Sles73/rocketa/OpenRocket/Valentina/decals/image-removebg-preview (3).png

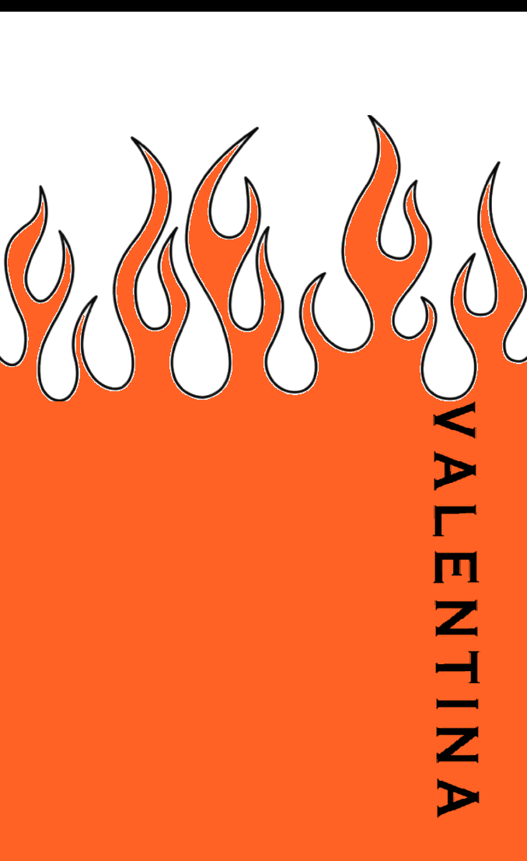
OpenRocket/Valentina/decals/image-removebg-preview (3).png
