Sles73/rocketa/construction/parts_V2.FCStd

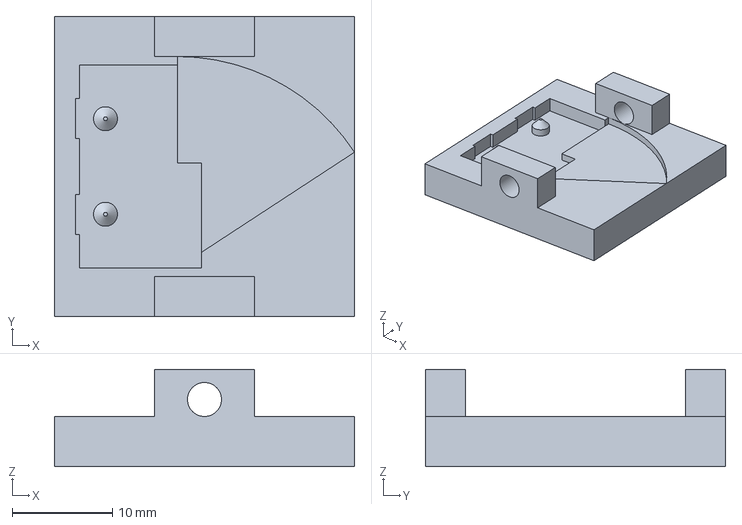
[picture p9: CAD file, 2026-05-04]
construction/parts_V2.FCStd
30.0 x 30.0 x 9.70 mm
