Sles73/rocketa/pcb/avionics/outline/pcb_outline_Page__.dxf

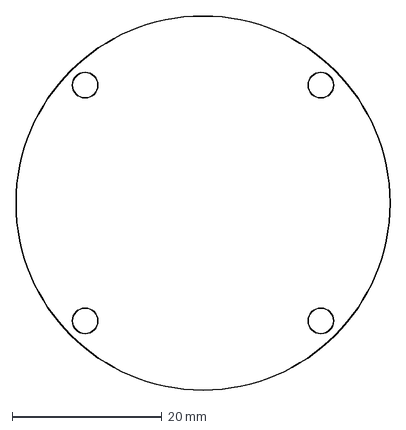
[picture p10: CAD file, 2026-05-04]
pcb/avionics/outline/pcb_outline_Page__.dxf
50.0 x 50.0 mm
