Sles73/rocketa/construction/parts.FCStd

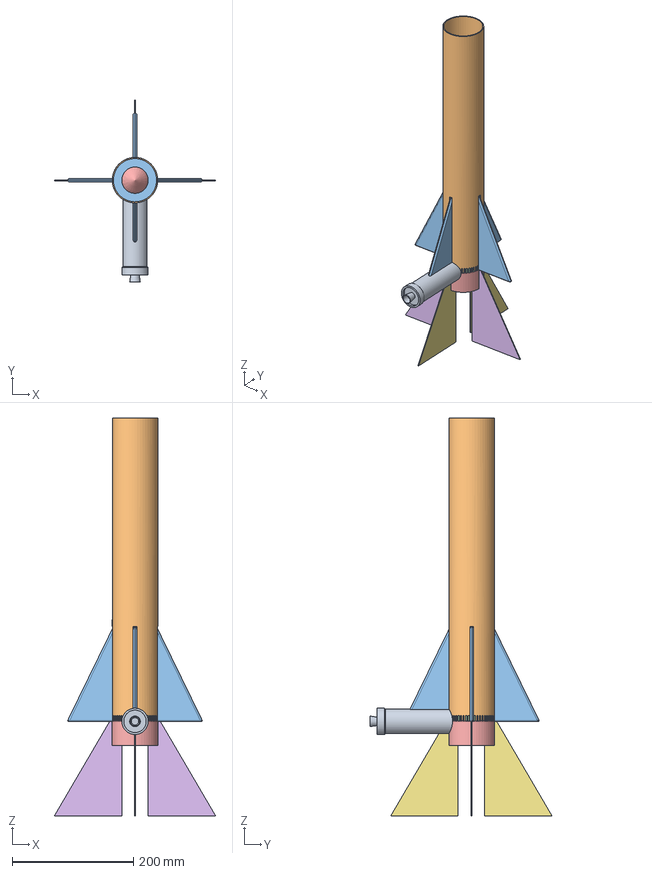
[picture p11: CAD file, 2026-05-04]
construction/parts.FCStd
266.1 x 300.3 x 656.0 mm
motorest
trubka
finsBody
cupler
mm1
mm2
