Sles73/rocketa/(list of files, cad)

Other CAD files:
pcb/avionics-com/outline/pcb_outline.FCStd
pcb/avionics-core-noob/outline/pcb_outline.FCStd
pcb/avionics-core/outline/pcb_outline.FCStd
pcb/avionics-power/outline/pcb_outline.FCStd
construction/rockter_realne.FCStd
pcb/avionics/outline/pcb_outline.FCStd
construction/rockter_mock.FCStd
