Sles73/rocketa/pcb/avionics-power/avionics.kicad_pcb

## KiCad design pcb/avionics-power/avionics.kicad_pcb (2026-05-04)

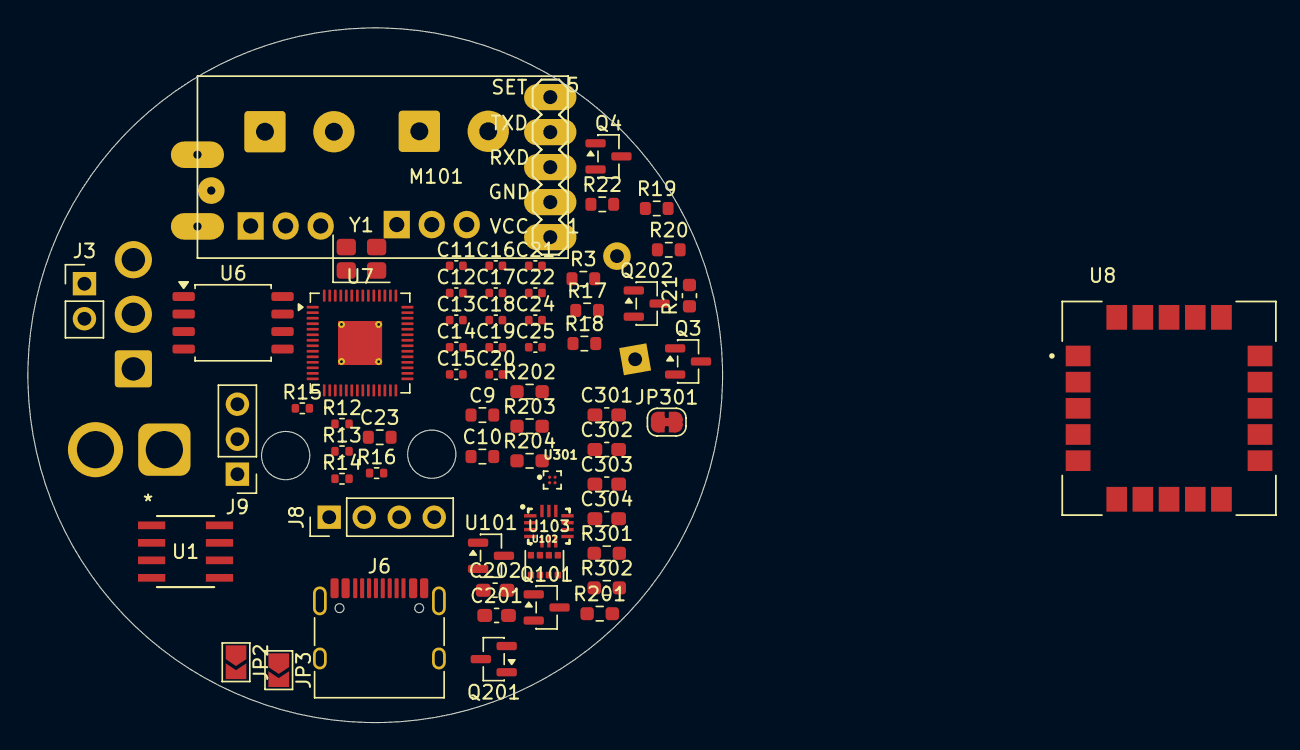
[picture p12: board avionics.kicad_pcb from above]

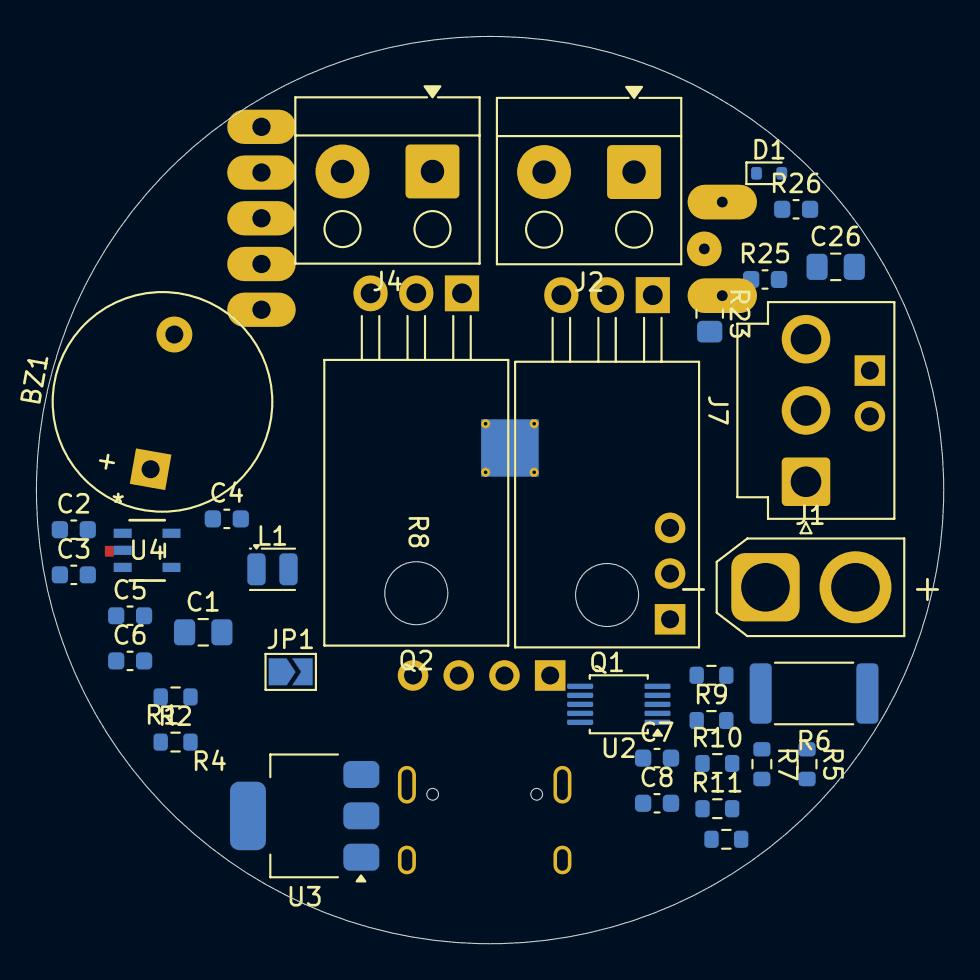
[picture p13: board avionics.kicad_pcb from below]

Board: 2 copper layers, 50.4 x 50.4 mm, 102 parts (35 on the bottom side), 55 nets, no tracks yet.

Parts:
BZ1: Buzzer; Buzzer_12x9.5RM7.6
C1: 22uF; C_0805_2012Metric_Pad1.18x1.45mm_HandSolder
C2: 10uF; C_0603_1608Metric
C3, C5, C6: 22uF; C_0603_1608Metric
C4: 22pF; C_0603_1608Metric
C7, C8: 100nF; C_0603_1608Metric
C9, C10, C23: 10u; R_0603_1608Metric
C11, C12, C13, C14, C15, C16, C17, C18, C19, C22: 100n; C_0402_1005Metric
C20, C21: 1u; C_0402_1005Metric
C24, C25: 15p; C_0402_1005Metric
C26: 1uF; C_0805_2012Metric_Pad1.18x1.45mm_HandSolder
C201, C202: 1uF; C_0603_1608Metric_Pad1.08x0.95mm_HandSolder
C301, C302, C303: 100nF; C_0603_1608Metric_Pad1.08x0.95mm_HandSolder
C304: 2.2uF; C_0603_1608Metric_Pad1.08x0.95mm_HandSolder
D1: ESD5Z3V3; D_SOD-523
H1, H2, H3, H4: MountingHole; MountingHole_2.7mm_M2.5
J1: Conn_batt; AMASS_XT30U-F_1x02_P5.0mm_Vertical
J2, J4: Palník_Terminal_01x02; Altech_AK100_1x02_P5.00mm
J3: Conn_01x02; PinHeader_1x02_P2.54mm_Vertical
J6: USB_C_Receptacle_USB2.0_16P; USB_C_Receptacle_HRO_TYPE-C-31-M-12
J7: RFB_switch; JST_VH_B3P-VH-B_1x03_P3.96mm_Vertical
J8: Conn_01x04_Pin; PinHeader_1x04_P2.54mm_Vertical
J9: Conn_01x03_Pin; PinHeader_1x03_P2.54mm_Vertical
JP1: SolderJumper_2_Open; SolderJumper-2_P1.3mm_Open_TrianglePad1.0x1.5mm
JP2: A1; SolderJumper-2_P1.3mm_Open_TrianglePad1.0x1.5mm
JP3: A0; SolderJumper-2_P1.3mm_Open_TrianglePad1.0x1.5mm
JP301: i2c; SolderJumper-2_P1.3mm_Bridged_RoundedPad1.0x1.5mm
L1: 2.2uH; L_Coilcraft_0805HQ_2012Metric
M101: HC-12; MA05-1
Q1, Q2: IRF9540N; TO-220-3_Horizontal_TabDown
Q3, Q4, Q202: SS8050; SOT-23
Q101, Q201: 2N7002; SOT-23
R1, R3, R7, R8, R9, R10, R11, R18, R19: 10k; R_0603_1608Metric
R2: 45k; R_0603_1608Metric
R4, R5: 10R; R_0603_1608Metric
R6: 5m; R_2512_6332Metric
R12, R13: 27; R_0402_1005Metric
R14: DNF; R_0402_1005Metric
R15, R16: 1k; R_0402_1005Metric
R17, R20, R22: 1k; R_0603_1608Metric
R21: 1k; C_0603_1608Metric
R23: 470R; R_0805_2012Metric_Pad1.20x1.40mm_HandSolder
R25: 10K; C_0603_1608Metric
R26: 18k; C_0603_1608Metric
R201, R202, R203, R204: 10k; R_0603_1608Metric_Pad0.98x0.95mm_HandSolder
R301, R302: 2.7k; R_0603_1608Metric_Pad0.98x0.95mm_HandSolder
U1: ATTINY402-SSNR; SOIC8_4P9X3P9MC_MCH
U2: INA226; TSSOP-10_3x3mm_P0.5mm
U3: AMS1117-3.3; SOT-223-3_TabPin2
U4: SY8089AAAC; SY8089AAAC_SGY
U6: W25Q128JVS; SOIC-8_5.3x5.3mm_P1.27mm
U7: RP2040; QFN-56-1EP_7x7mm_P0.4mm_EP3.2x3.2mm_ThermalVias
U8: SAM-M8Q-0-10; MODULE_SAM-M8Q-0-10
U101: ME6206A18XG; SOT-23
U102: ICP-10111; PSON65P250X200X100-8N
U103: LSM6DS3TR-C; LGA-14-2.5X3MM
U301: MMC5603NJ; XDCR_MMC5603NJ
Y1: ABM8-272-T3; Crystal_SMD_3225-4Pin_3.2x2.5mm

Connections:
+1V1: C11.1, C12.1, C20.1, U7.23 (DVDD), U7.45 (VREG_VOUT), U7.50 (DVDD)
+3V3: C4.1, C5.1, C6.1, C8.2, C10.1, C13.1, C14.1, C15.1, C16.1, C17.1, C18.1, C19.1, C21.1, C22.1, C23.1, C201.1, C301.1, C302.1, C303.1, C304.1, J8.2, J9.2, JP1.2 (B), JP2.2 (B), JP3.2 (B), JP301.1 (A), L1.2, R2.1, R9.2, R10.2, R11.2, R14.1, R202.1, R204.1, R301.1, R302.1, U1.1 (VDD), U2.6 (VS), U6.8 (VCC), U7.1 (IOVDD), U7.10 (IOVDD), U7.22 (IOVDD), U7.33 (IOVDD), U7.42 (IOVDD), U7.43 (ADC_AVDD), U7.44 (VREG_IN), U7.48 (USB_VDD), U7.49 (IOVDD), U101.3 (VI), U103.5 (VDDIO), U103.8 (VDD), U301.B1 (VDD)
+VDC: BZ1.1 (+), C1.1, C2.2, J7.1, R1.1, R5.2, R6.2, R26.1, U3.3 (VI), U4.4 (IN)
/GPS/+3V3: U8.2 (VCC_IO), U8.3 (V_BCKP), U8.17 (VCC)
/IMU/SCL: R302.2, U103.13 (SCL), U301.A2 (SCL)
/IMU/SDA: R301.2, U103.14 (SDA), U301.B2 (SDA)
/backup_mtp/palnik_backup: R20.2, U1.4 (PA1)
/barometr/SCL: Q101.3 (D), R202.2
/barometr/SDA: Q201.3 (D), R204.2
/ejection_charge_safety/Sw1: C26.1, R23.1
/ejection_charge_safety/VCC_palnik: J7.3, Q1.3 (S), Q2.3 (S), R18.2, R19.2
/mcu/QSPI_SCLK: U6.6 (CLK), U7.52 (QSPI_SCLK)
/mcu/QSPI_SD0: U6.5 (DI(IO0)), U7.53 (QSPI_SD0)
/mcu/QSPI_SD1: U6.2 (DO(IO1)), U7.55 (QSPI_SD1)
/mcu/QSPI_SD2: U6.3 (IO2), U7.54 (QSPI_SD2)
/mcu/QSPI_SD3: U6.7 (IO3), U7.51 (QSPI_SD3)
/mcu/QSPI_SS: R14.2, R15.1, U6.1 (~CS), U7.56 (QSPI_SS)
/mcu/USB_D+: J6.A6 (D+), J6.B6 (D+), R12.1
/mcu/USB_D-: J6.A7 (D-), J6.B7 (D-), R13.1
/mcu/XIN: C24.1, U7.20 (XIN), Y1.1
/mcu/XOUT: R16.1, U7.21 (XOUT)
/mcu/~USB_BOOT: J3.1, R15.2
/power_management/Alert: R11.1, U2.3 (~Alert)
/power_management/SCL: R10.1, U2.5 (SCL)
/power_management/SDA: R9.1, U2.4 (SDA)
/power_management/VCC_batt: J1.2, R4.2, R6.1, U2.8 (Vbus)
GND: C1.2, C2.1, C3.1, C5.2, C6.2, C9.2, C10.2, C11.2, C12.2, C13.2, C14.2, C15.2, C16.2, C17.2, C18.2, C19.2, C20.2, C21.2, C22.2, C23.2, C24.2, C25.2, C26.2, C201.2, C202.2, C301.2, C302.2, C303.2, C304.2, D1.2 (A), J1.1, J2.1, J3.2, J4.1, J6.A1 (GND), J6.A12 (GND), J6.B1 (GND), J6.B12 (GND), J6.SH (SHIELD), J8.1, J9.3, Q3.2 (E), Q4.2 (E), Q202.2 (E), R3.2, R7.1, R8.1, R25.2, U1.8 (GND), U2.7 (GND), U3.1 (GND), U4.2 (GND), U6.4 (GND), U7.19 (TESTEN), U7.57 (GND), U8.1 (GND), U8.4 (GND), U8.5 (GND), U8.6 (GND), U8.10 (GND), U8.11 (GND), U8.15 (GND), U8.16 (GND), U8.20 (GND), U101.1 (GND), U102.1 (GND), U102.5 (RESV5), U102.7 (GND), U103.1 (SDO/SA0), U103.2 (SDX), U103.3 (SCX), U103.6 (GND), U103.7 (GND), U301.A1 (VSA), Y1.2, Y1.4
unnamed: BZ1.2 (-), Q4.3 (C)
unnamed: C25.1, R16.2, Y1.3
unnamed: D1.1 (K), J7.2, R23.2, R25.1, R26.2
unnamed: J2.2, Q1.2 (D)
unnamed: J4.2, Q2.2 (D)
unnamed: J8.3, J9.1, R21.2, U1.6 (PA0/RESET/UPDI)
unnamed: J8.4, R21.1
unnamed: C3.2, JP1.1 (A), U3.2 (VO)
unnamed: JP2.1 (A), R7.2, U2.1 (A1)
unnamed: JP3.1 (A), R8.2, U2.2 (A0)
unnamed: JP301.2 (B), U103.12 (CS)
unnamed: M101.GND (GND1), M101.GND1
unnamed: Q1.1 (G), Q3.3 (C), R19.1
unnamed: Q2.1 (G), Q202.3 (C), R18.1
unnamed: Q3.1 (B), R20.1
unnamed: Q4.1 (B), R22.1
unnamed: C202.1, Q101.1 (G), Q201.1 (G), R201.1, R203.1, U101.2 (VO), U102.8 (VDD)
unnamed: Q101.2 (S), R201.2, U102.4 (SCL)
unnamed: Q201.2 (S), R203.2, U102.3 (SDA)
unnamed: Q202.1 (B), R17.1
unnamed: C7.1, R4.1, U2.10 (Vin+)
unnamed: C7.2, R5.1, U2.9 (Vin-)
unnamed: R1.2, U4.1 (EN)
unnamed: C4.2, R2.2, R3.1, U4.5 (FB)
unnamed: L1.1, U4.3 (LX)
unnamed: R13.2, U7.46 (USB_DM)
unnamed: R12.2, U7.47 (USB_DP)
VBUS: C9.1, J6.A4 (VBUS), J6.A9 (VBUS), J6.B4 (VBUS), J6.B9 (VBUS)
