Sles73/rocketa/pcb/avionics-power/avionics-power.kicad_pcb

## KiCad design pcb/avionics-power/avionics-power.kicad_pcb (2026-05-04)

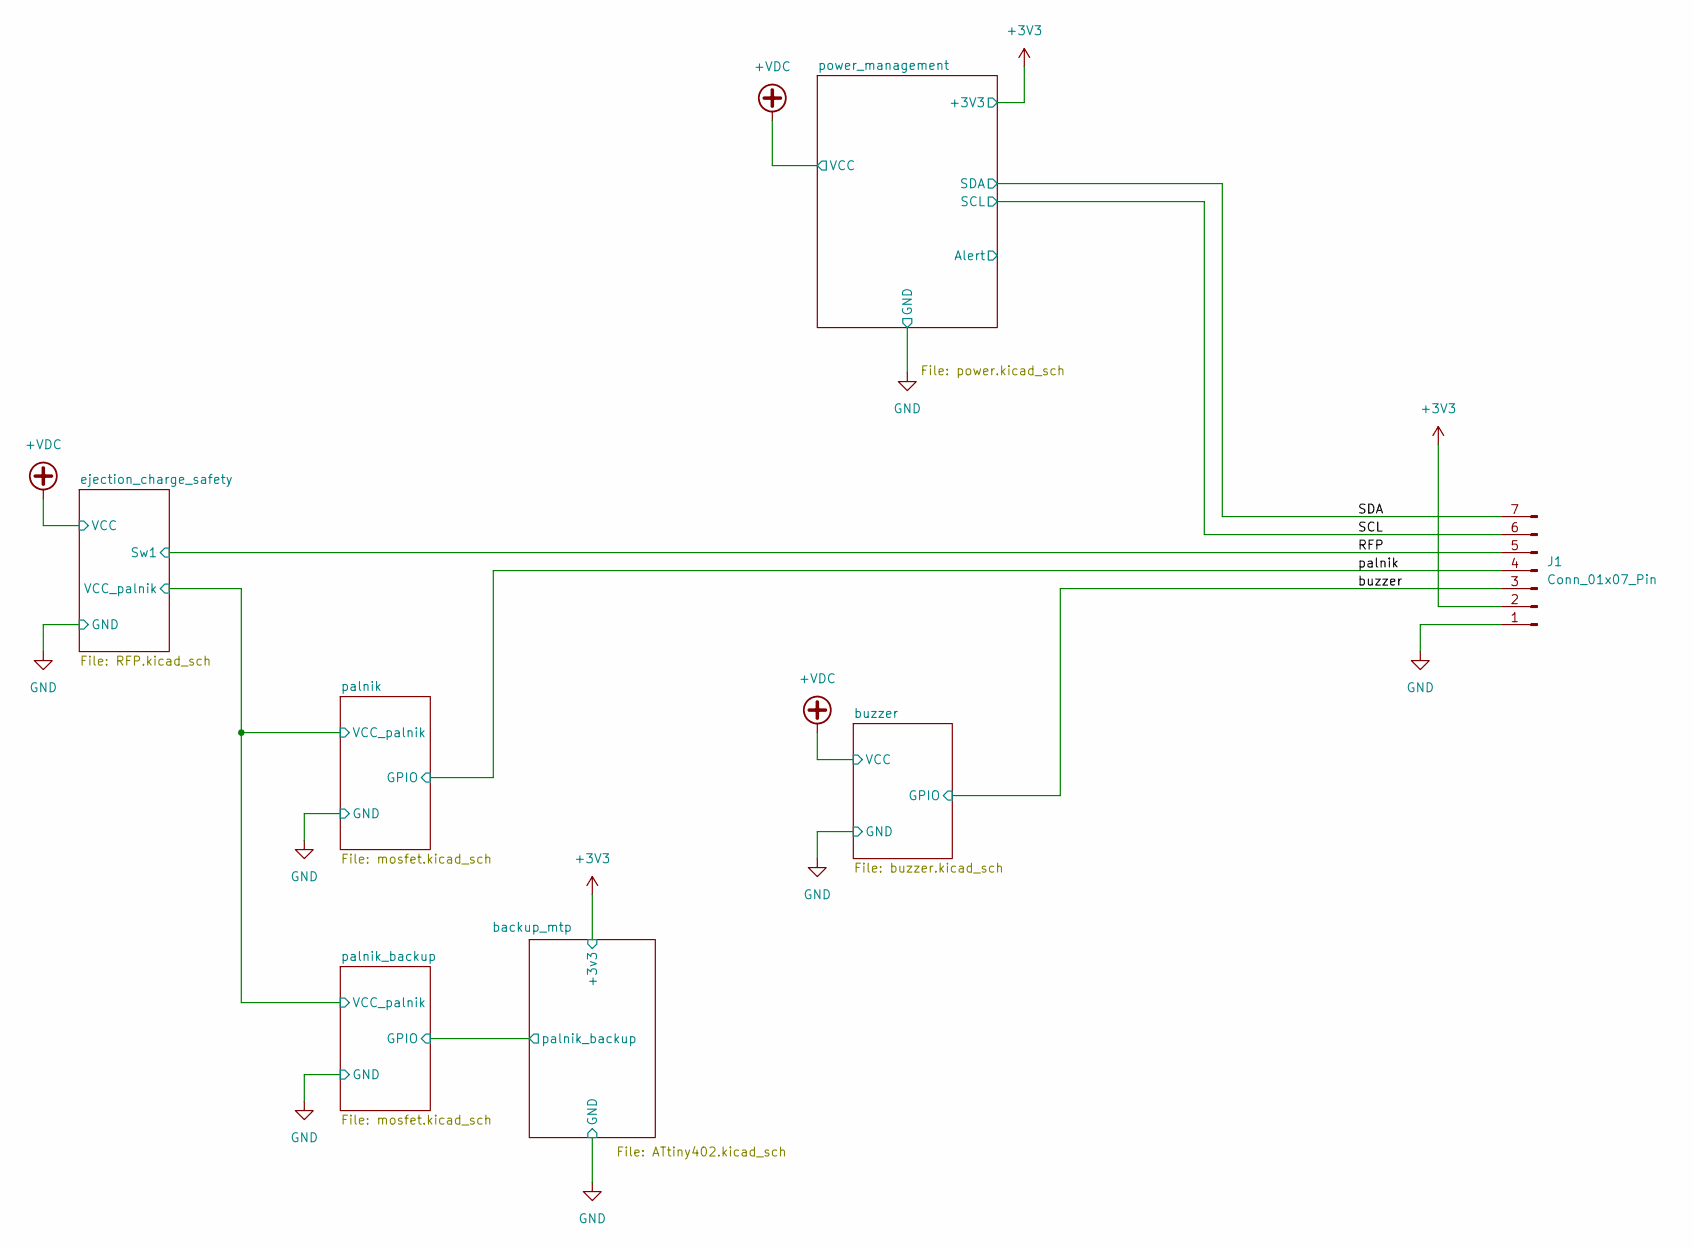
[picture p14: schematic avionics-power.kicad_sch]

Parts:
J1: Conn_01x07_Pin; JST_XA_S07B-XASK-1_1x07_P2.50mm_Horizontal

Connections:
+3V3: J1.2; also elsewhere on the board
/buzzer/GPIO: J1.3; also elsewhere on the board
/ejection_charge_safety/Sw1: J1.5; also elsewhere on the board
/palnik/GPIO: J1.4; also elsewhere on the board
/power_management/SCL: J1.6; also elsewhere on the board
/power_management/SDA: J1.7; also elsewhere on the board
GND: J1.1; also elsewhere on the board

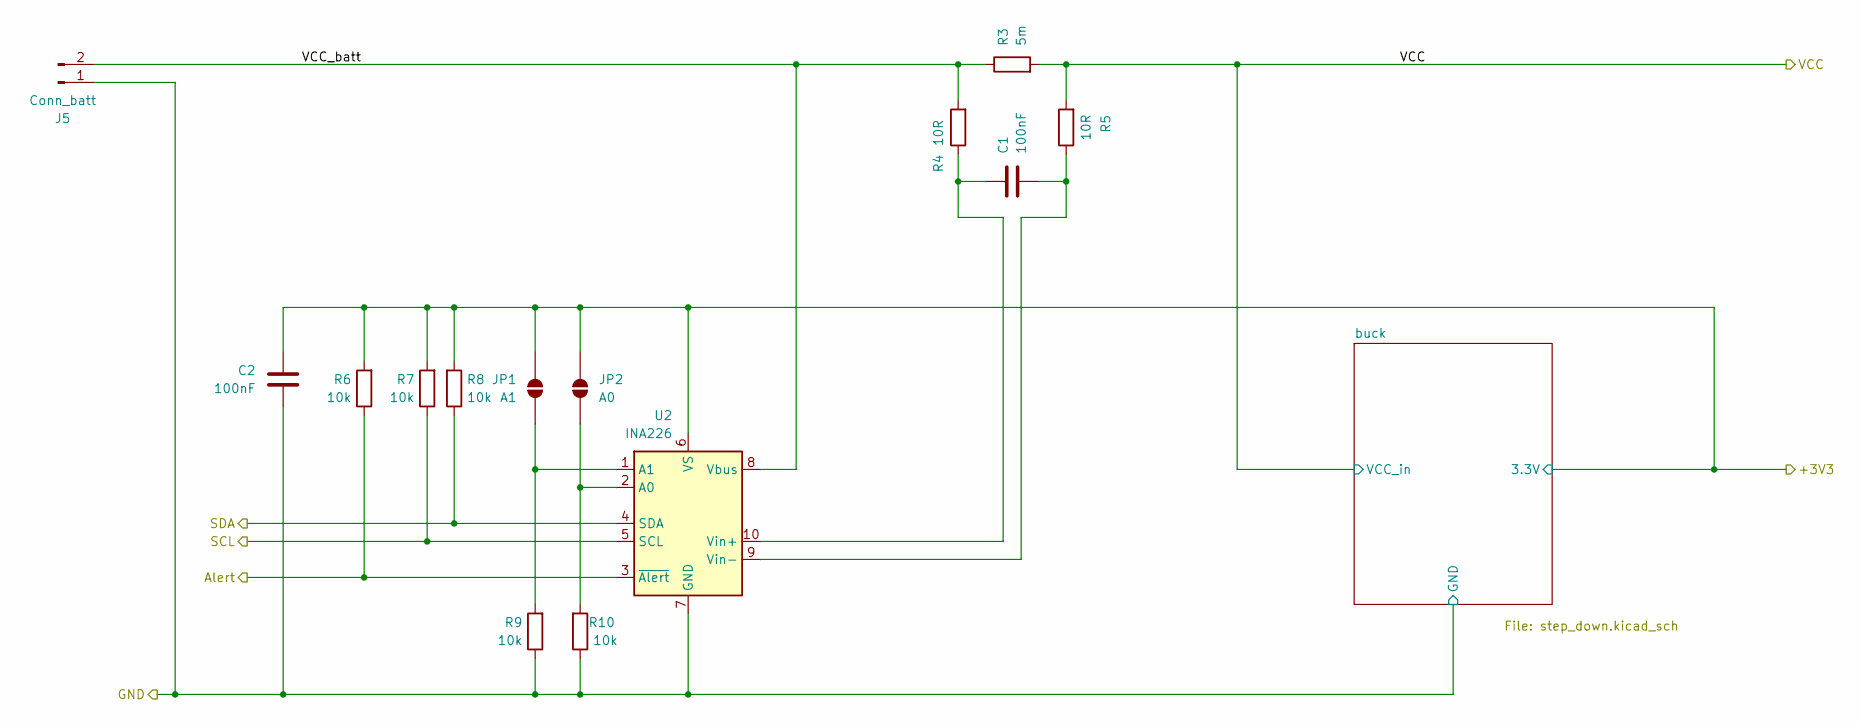
[picture p15: schematic power.kicad_sch]

Parts:
C1, C2: 100nF; C_0603_1608Metric
J5: Conn_batt; AMASS_XT30U-F_1x02_P5.0mm_Vertical
JP1: A1; SolderJumper-2_P1.3mm_Open_TrianglePad1.0x1.5mm
JP2: A0; SolderJumper-2_P1.3mm_Open_TrianglePad1.0x1.5mm
R3: 5m; R_2512_6332Metric
R4, R5: 10R; R_0603_1608Metric
R6, R7, R8, R9, R10: 10k; R_0603_1608Metric
U2: INA226; TSSOP-10_3x3mm_P0.5mm

Connections:
+3V3: C2.2, JP1.2 (B), JP2.2 (B), R6.2, R7.2, R8.2, U2.6 (VS); also elsewhere on the board
+VDC: R3.2, R5.2; also elsewhere on the board
/power_management/Alert: R6.1, U2.3 (~Alert)
/power_management/SCL: R7.1, U2.5 (SCL); also elsewhere on the board
/power_management/SDA: R8.1, U2.4 (SDA); also elsewhere on the board
/power_management/VCC_batt: J5.2, R3.1, R4.2, U2.8 (Vbus)
GND: C2.1, J5.1, R9.1, R10.1, U2.7 (GND); also elsewhere on the board
unnamed: JP1.1 (A), R9.2, U2.1 (A1)
unnamed: JP2.1 (A), R10.2, U2.2 (A0)
unnamed: C1.1, R4.1, U2.10 (Vin+)
unnamed: C1.2, R5.1, U2.9 (Vin-)

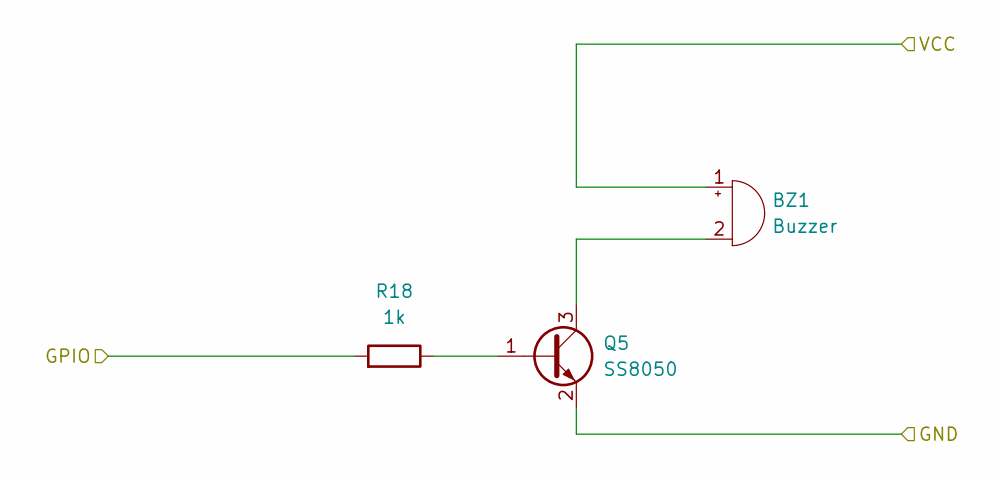
[picture p16: schematic buzzer.kicad_sch]

Parts:
BZ1: Buzzer; Buzzer_12x9.5RM7.6
Q5: SS8050; SOT-23
R18: 1k; R_0603_1608Metric

Connections:
+VDC: BZ1.1 (+); also elsewhere on the board
/buzzer/GPIO: R18.2; also elsewhere on the board
GND: Q5.2 (E); also elsewhere on the board
unnamed: BZ1.2 (-), Q5.3 (C)
unnamed: Q5.1 (B), R18.1

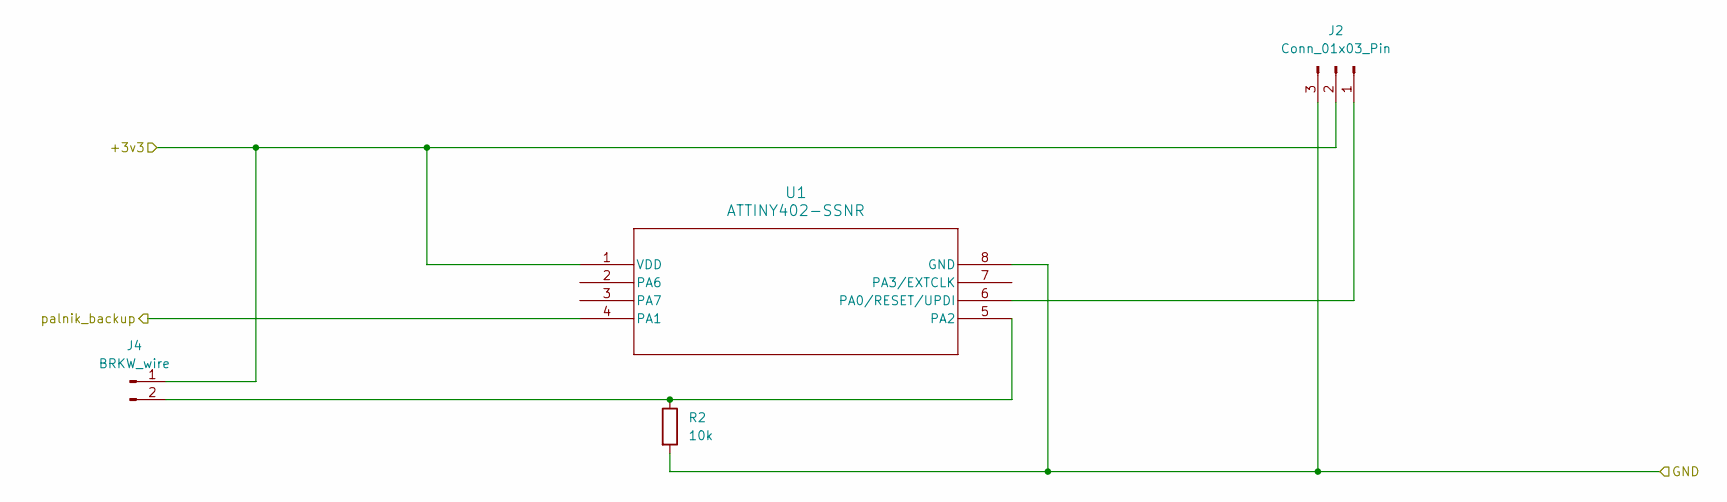
[picture p17: schematic ATtiny402.kicad_sch]

Parts:
J2: Conn_01x03_Pin; PinHeader_1x03_P2.54mm_Vertical
J4: BRKW_wire; JST_PH_B2B-PH-K_1x02_P2.00mm_Vertical
R2: 10k; C_0603_1608Metric
U1: ATTINY402-SSNR; SOIC8_4P9X3P9MC_MCH

Connections:
+3V3: J2.2, J4.1, U1.1 (VDD); also elsewhere on the board
/backup_mtp/palnik_backup: U1.4 (PA1); also elsewhere on the board
GND: J2.3, R2.2, U1.8 (GND); also elsewhere on the board
unnamed: J2.1, U1.6 (PA0/RESET/UPDI)
unnamed: J4.2, R2.1, U1.5 (PA2)

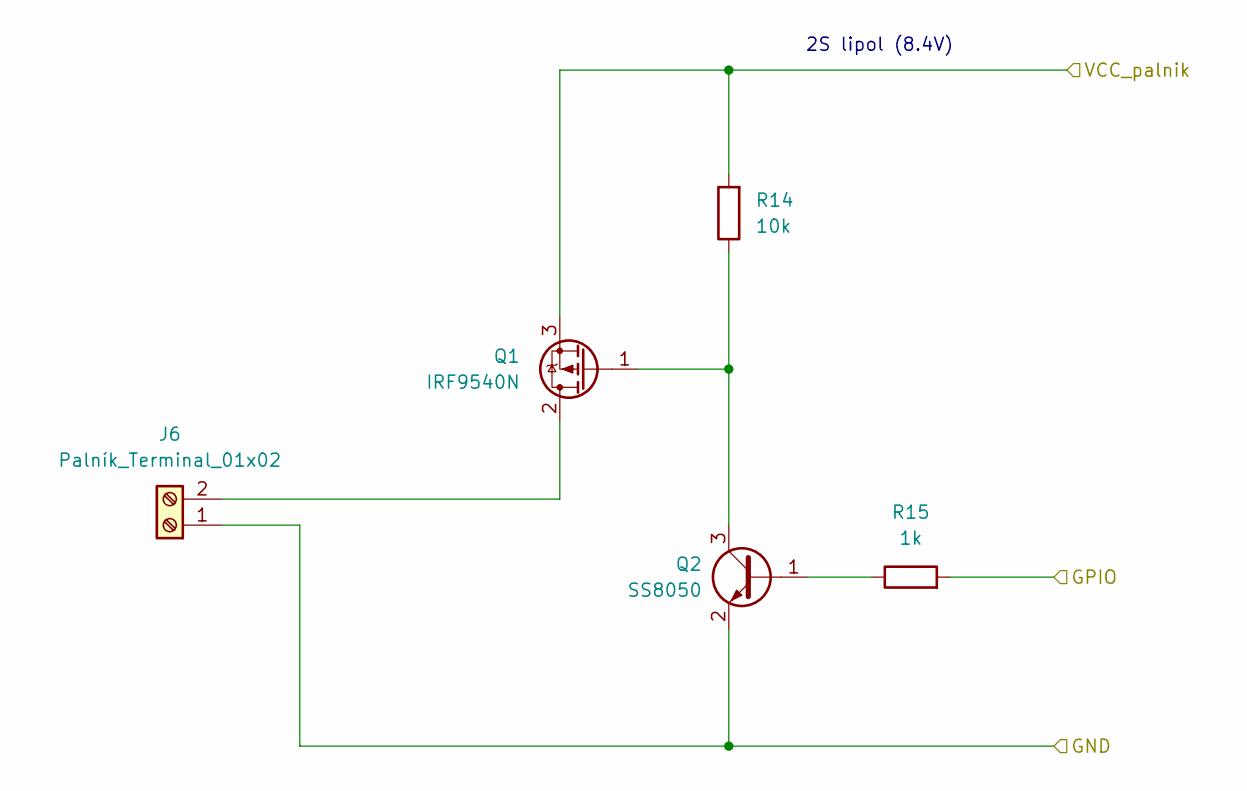
[picture p18: schematic mosfet.kicad_sch]

Parts:
J6: Palník_Terminal_01x02; Altech_AK100_1x02_P5.00mm
Q1: IRF9540N; TO-220-3_Horizontal_TabDown
Q2: SS8050; SOT-23
R14: 10k; R_0603_1608Metric
R15: 1k; R_0603_1608Metric

Connections:
/ejection_charge_safety/VCC_palnik: Q1.3 (S), R14.2; also elsewhere on the board
/palnik/GPIO: R15.2; also elsewhere on the board
GND: J6.1, Q2.2 (E); also elsewhere on the board
unnamed: J6.2, Q1.2 (D)
unnamed: Q1.1 (G), Q2.3 (C), R14.1
unnamed: Q2.1 (B), R15.1

Parts of its further copies:
J7: Palník_Terminal_01x02; Altech_AK100_1x02_P5.00mm
Q3: IRF9540N; TO-220-3_Horizontal_TabDown
Q4: SS8050; SOT-23
R16: 10k; R_0603_1608Metric
R17: 1k; R_0603_1608Metric

Connections of its further copies:
/backup_mtp/palnik_backup: R17.2; also elsewhere on the board
/ejection_charge_safety/VCC_palnik: Q3.3 (S), R16.2; also elsewhere on the board
GND: J7.1, Q4.2 (E); also elsewhere on the board
unnamed: J7.2, Q3.2 (D)
unnamed: Q3.1 (G), Q4.3 (C), R16.1
unnamed: Q4.1 (B), R17.1

Notes on the sheet:
2S lipol (8.4V)

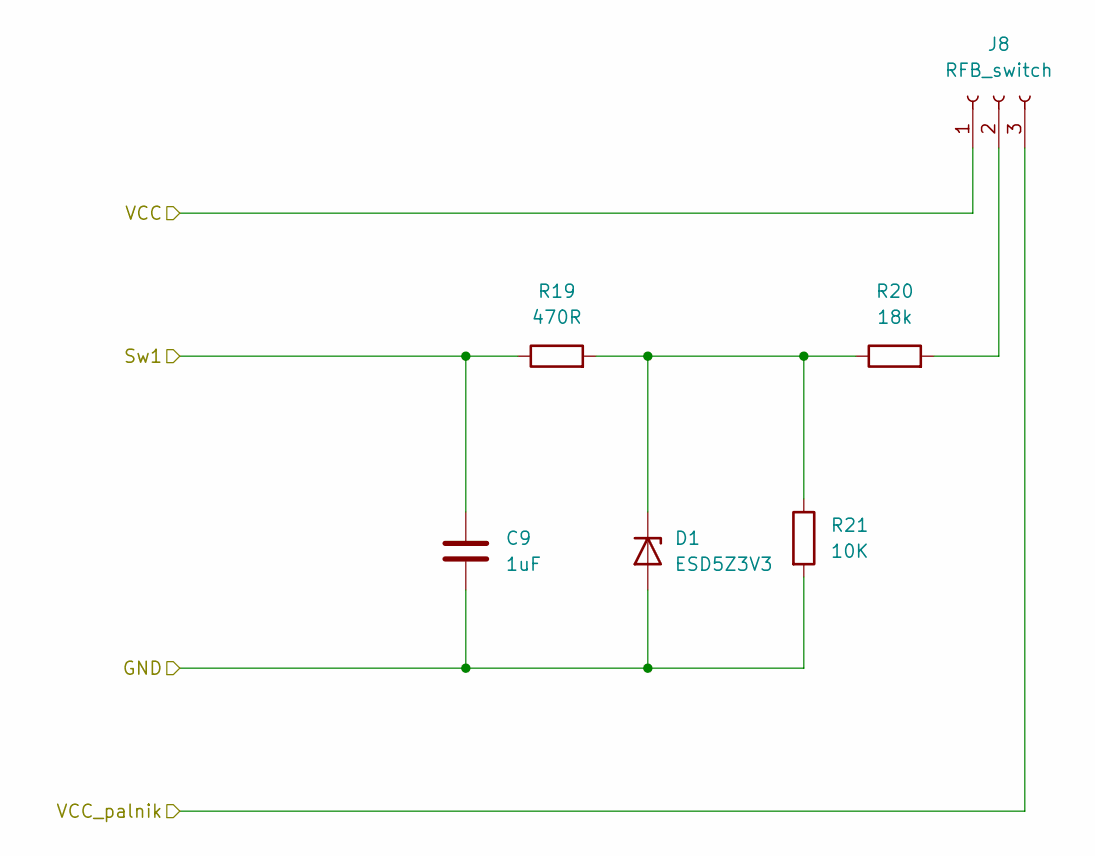
[picture p19: schematic RFP.kicad_sch]

Parts:
C9: 1uF; C_0805_2012Metric_Pad1.18x1.45mm_HandSolder
D1: ESD5Z3V3; D_SOD-523
J8: RFB_switch; JST_VH_B3P-VH-B_1x03_P3.96mm_Vertical
R19: 470R; R_0805_2012Metric_Pad1.20x1.40mm_HandSolder
R20: 18k; C_0603_1608Metric
R21: 10K; C_0603_1608Metric

Connections:
+VDC: J8.1; also elsewhere on the board
/ejection_charge_safety/Sw1: C9.1, R19.1; also elsewhere on the board
/ejection_charge_safety/VCC_palnik: J8.3; also elsewhere on the board
GND: C9.2, D1.2 (A), R21.2; also elsewhere on the board
unnamed: D1.1 (K), R19.2, R20.1, R21.1
unnamed: J8.2, R20.2

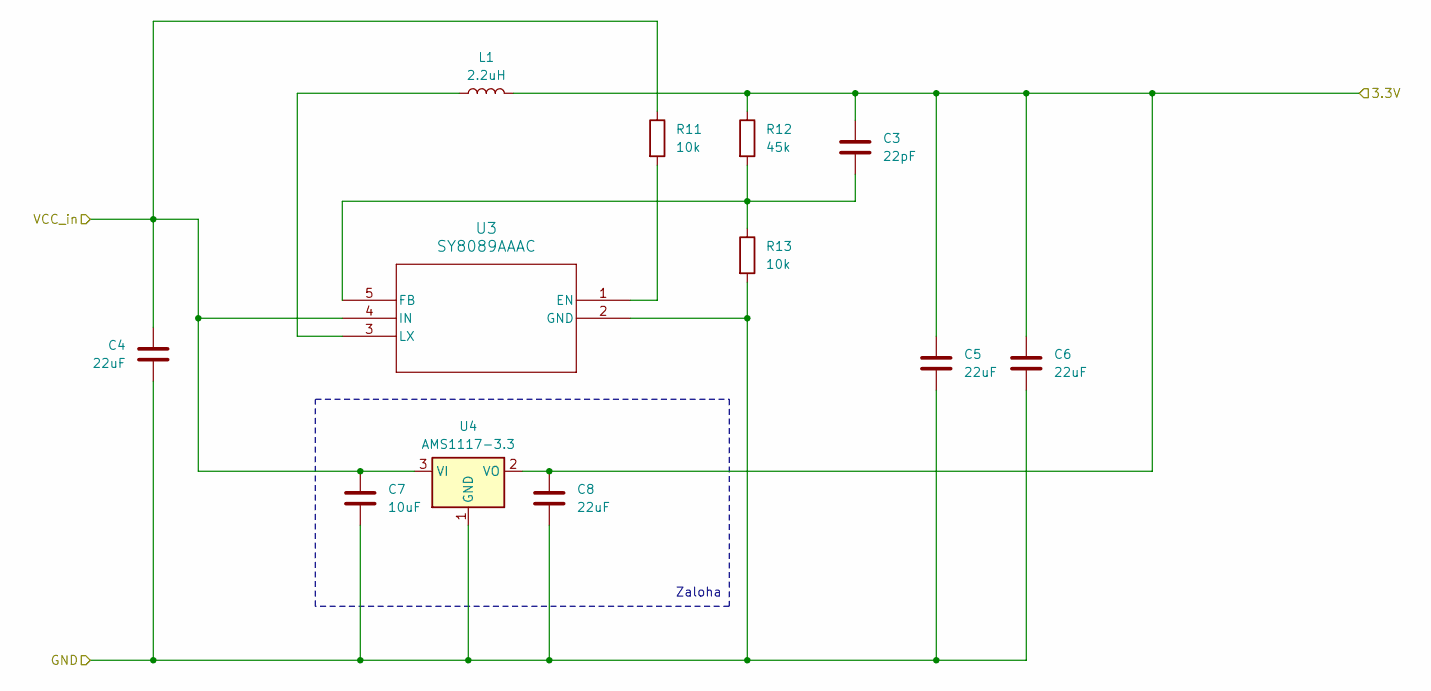
[picture p20: schematic step_down.kicad_sch]

Parts:
C3: 22pF; C_0603_1608Metric
C4, C5, C6, C8: 22uF; C_0603_1608Metric
C7: 10uF; C_0603_1608Metric
L1: 2.2uH; L_Coilcraft_0805HQ_2012Metric
R11, R13: 10k; R_0603_1608Metric
R12: 45k; R_0603_1608Metric
U3: SY8089AAAC; SY8089AAAC_SGY
U4: AMS1117-3.3; SOT-223-3_TabPin2

Connections:
+3V3: C3.1, C5.1, C6.1, C8.2, L1.2, R12.1, U4.2 (VO); also elsewhere on the board
+VDC: C4.1, C7.2, R11.1, U3.4 (IN), U4.3 (VI); also elsewhere on the board
GND: C4.2, C5.2, C6.2, C7.1, C8.1, R13.2, U3.2 (GND), U4.1 (GND); also elsewhere on the board
unnamed: R11.2, U3.1 (EN)
unnamed: C3.2, R12.2, R13.1, U3.5 (FB)
unnamed: L1.1, U3.3 (LX)

Notes on the sheet:
Zaloha

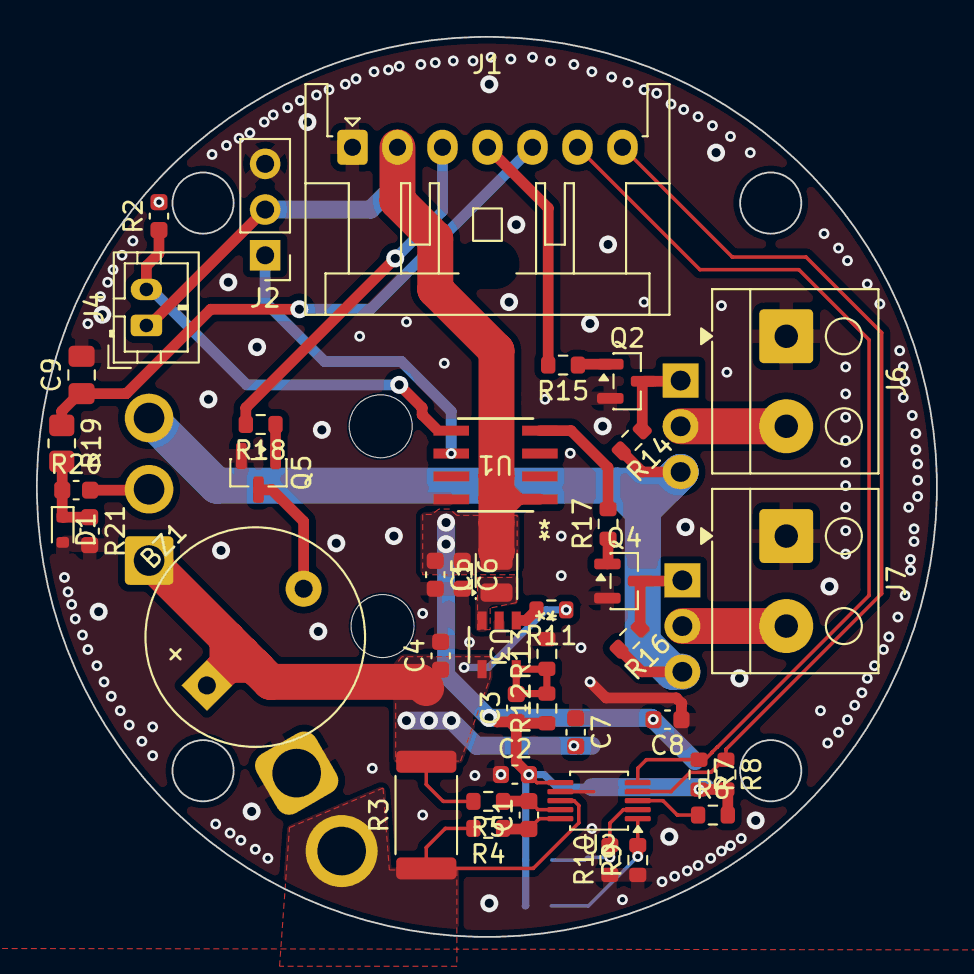
[picture p21: board avionics-power.kicad_pcb from above]

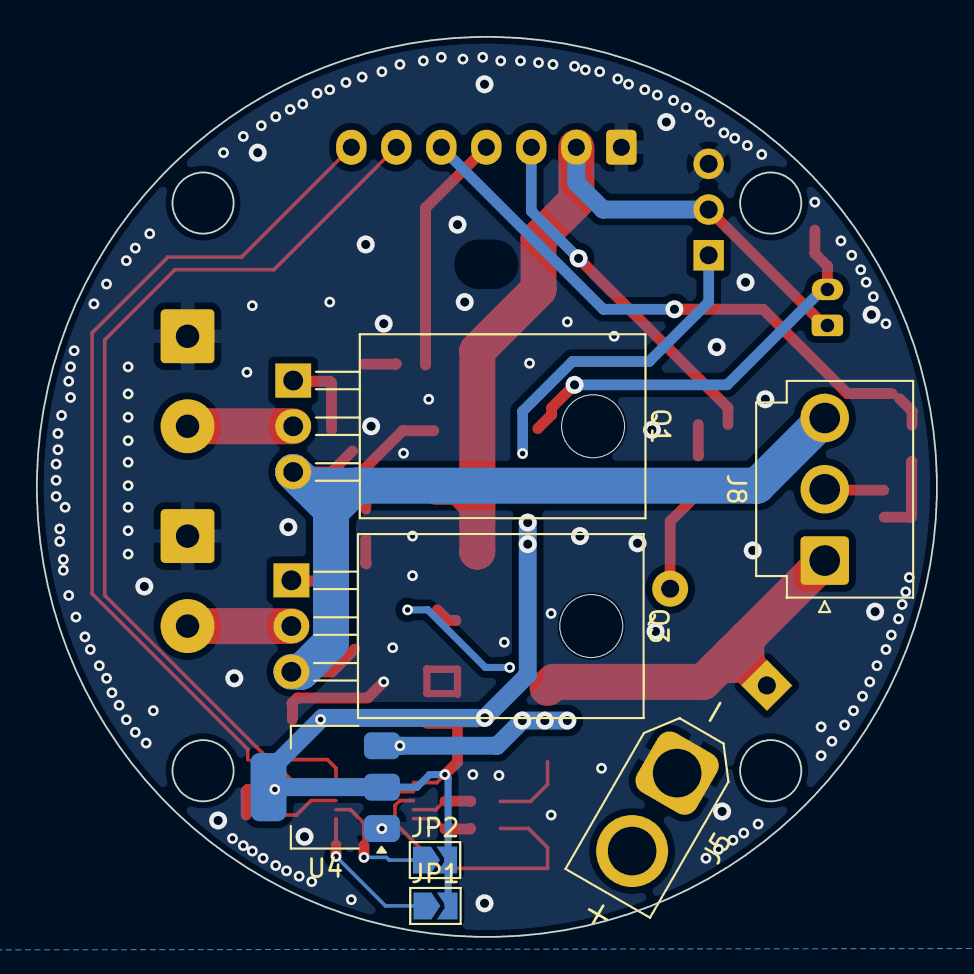
[picture p22: board avionics-power.kicad_pcb from below]

Board: 2 copper layers, 50.0 x 50.0 mm, 50 parts (7 on the bottom side), 31 nets.
