Sles73/rocketa/pcb/avionics-core-noob/avionics-core-noob.kicad_pcb

## KiCad design pcb/avionics-core-noob/avionics-core-noob.kicad_pcb (2026-05-04)

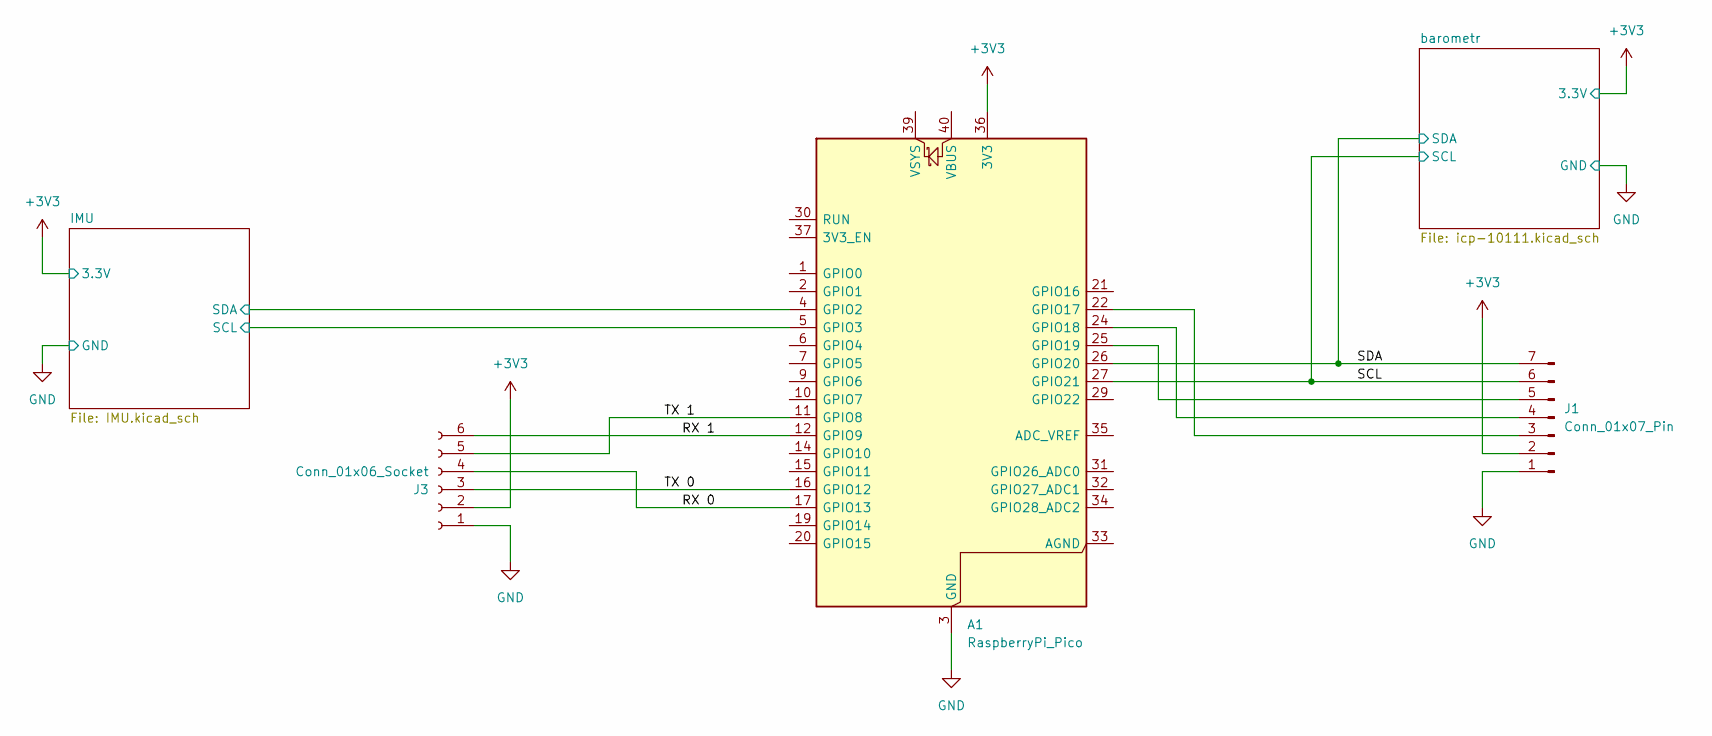
[picture p23: schematic avionics-core-noob.kicad_sch]

Parts:
A1: RaspberryPi_Pico; RaspberryPi_Pico_Common_Unspecified
J1: Conn_01x07_Pin; JST_XA_S07B-XASK-1_1x07_P2.50mm_Horizontal
J3: Conn_01x06_Socket; JST_XA_S06B-XASK-1_1x06_P2.50mm_Horizontal

Connections:
+3V3: A1.36 (3V3), J1.2, J3.2; also elsewhere on the board
/IMU/SCL: A1.5 (GPIO3); also elsewhere on the board
/IMU/SDA: A1.4 (GPIO2); also elsewhere on the board
/RX 0: A1.17 (GPIO13), J3.4
/RX 1: A1.12 (GPIO9), J3.6
/TX 0: A1.16 (GPIO12), J3.3
/TX 1: A1.11 (GPIO8), J3.5
/barometr/SCL: A1.27 (GPIO21), J1.6; also elsewhere on the board
/barometr/SDA: A1.26 (GPIO20), J1.7; also elsewhere on the board
GND: A1.3 (GND), A1.8 (GND), A1.13 (GND), A1.18 (GND), A1.23 (GND), A1.28 (GND), A1.38 (GND), J1.1, J3.1; also elsewhere on the board
unnamed: A1.22 (GPIO17), J1.3
unnamed: A1.24 (GPIO18), J1.4
unnamed: A1.25 (GPIO19), J1.5

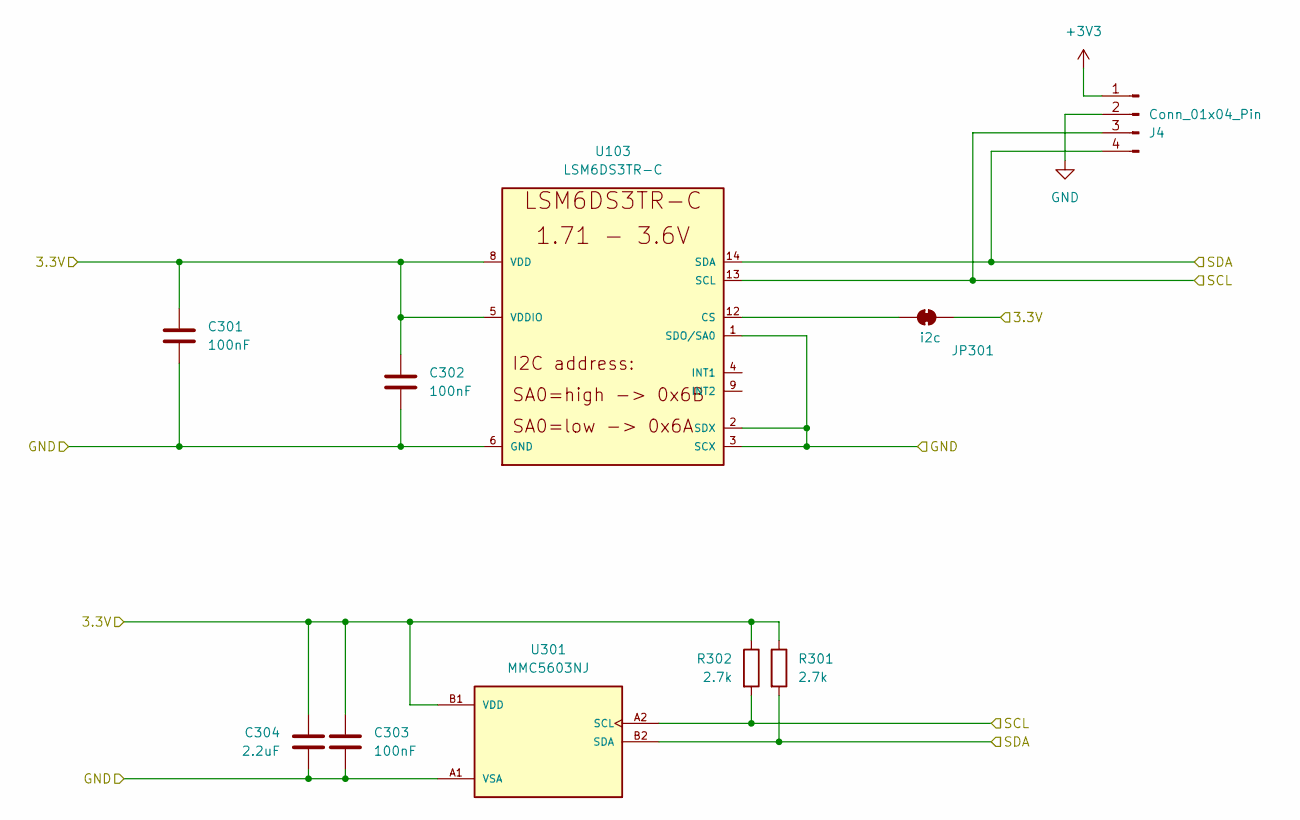
[picture p24: schematic IMU.kicad_sch]

Parts:
C301, C302, C303: 100nF; C_0603_1608Metric_Pad1.08x0.95mm_HandSolder
C304: 2.2uF; C_0603_1608Metric_Pad1.08x0.95mm_HandSolder
J4: Conn_01x04_Pin; PinHeader_1x04_P2.54mm_Vertical
JP301: i2c; SolderJumper-2_P1.3mm_Bridged_RoundedPad1.0x1.5mm
R301, R302: 2.7k; R_0603_1608Metric_Pad0.98x0.95mm_HandSolder
U103: LSM6DS3TR-C; LGA-14-2.5X3MM
U301: MMC5603NJ; XDCR_MMC5603NJ; PARTREV B

Connections:
+3V3: C301.1, C302.1, C303.1, C304.1, J4.1, JP301.1 (A), R301.1, R302.1, U103.5 (VDDIO), U103.8 (VDD), U301.B1 (VDD); also elsewhere on the board
/IMU/SCL: J4.3, R302.2, U103.13 (SCL), U301.A2 (SCL); also elsewhere on the board
/IMU/SDA: J4.4, R301.2, U103.14 (SDA), U301.B2 (SDA); also elsewhere on the board
GND: C301.2, C302.2, C303.2, C304.2, J4.2, U103.1 (SDO/SA0), U103.2 (SDX), U103.3 (SCX), U103.6 (GND), U103.7 (GND), U301.A1 (VSA); also elsewhere on the board
unnamed: JP301.2 (B), U103.12 (CS)

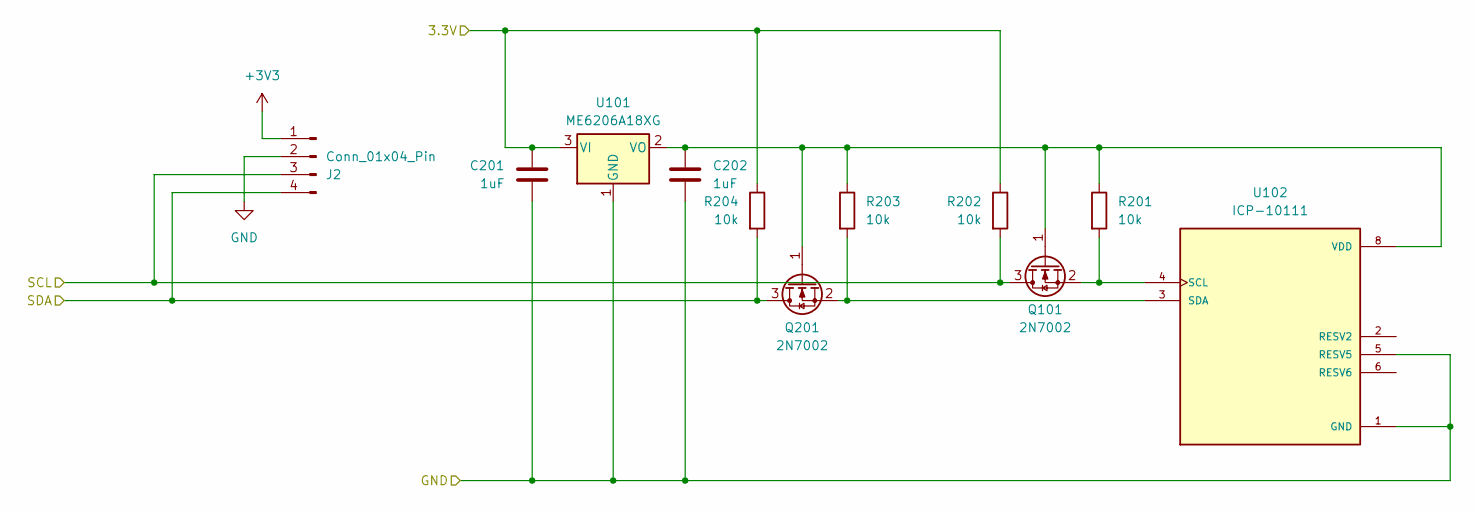
[picture p25: schematic icp-10111.kicad_sch]

Parts:
C201, C202: 1uF; C_0603_1608Metric_Pad1.08x0.95mm_HandSolder
J2: Conn_01x04_Pin; PinHeader_1x04_P2.54mm_Vertical
Q101, Q201: 2N7002; SOT-23
R201, R202, R203, R204: 10k; R_0603_1608Metric_Pad0.98x0.95mm_HandSolder
U101: ME6206A18XG; SOT-23
U102: ICP-10111; PSON65P250X200X100-8N; PARTREV 1.0

Connections:
+3V3: C201.1, J2.1, R202.1, R204.1, U101.3 (VI); also elsewhere on the board
/barometr/SCL: J2.3, Q101.3 (D), R202.2; also elsewhere on the board
/barometr/SDA: J2.4, Q201.3 (D), R204.2; also elsewhere on the board
GND: C201.2, C202.2, J2.2, U101.1 (GND), U102.1 (GND), U102.5 (RESV5), U102.7 (GND); also elsewhere on the board
unnamed: C202.1, Q101.1 (G), Q201.1 (G), R201.1, R203.1, U101.2 (VO), U102.8 (VDD)
unnamed: Q101.2 (S), R201.2, U102.4 (SCL)
unnamed: Q201.2 (S), R203.2, U102.3 (SDA)
