Sles73/rocketa/pcb/avionics-core-noob/avionics-core-noob.kicad_pcb

## KiCad design pcb/avionics-core-noob/avionics-core-noob.kicad_pcb (continued)

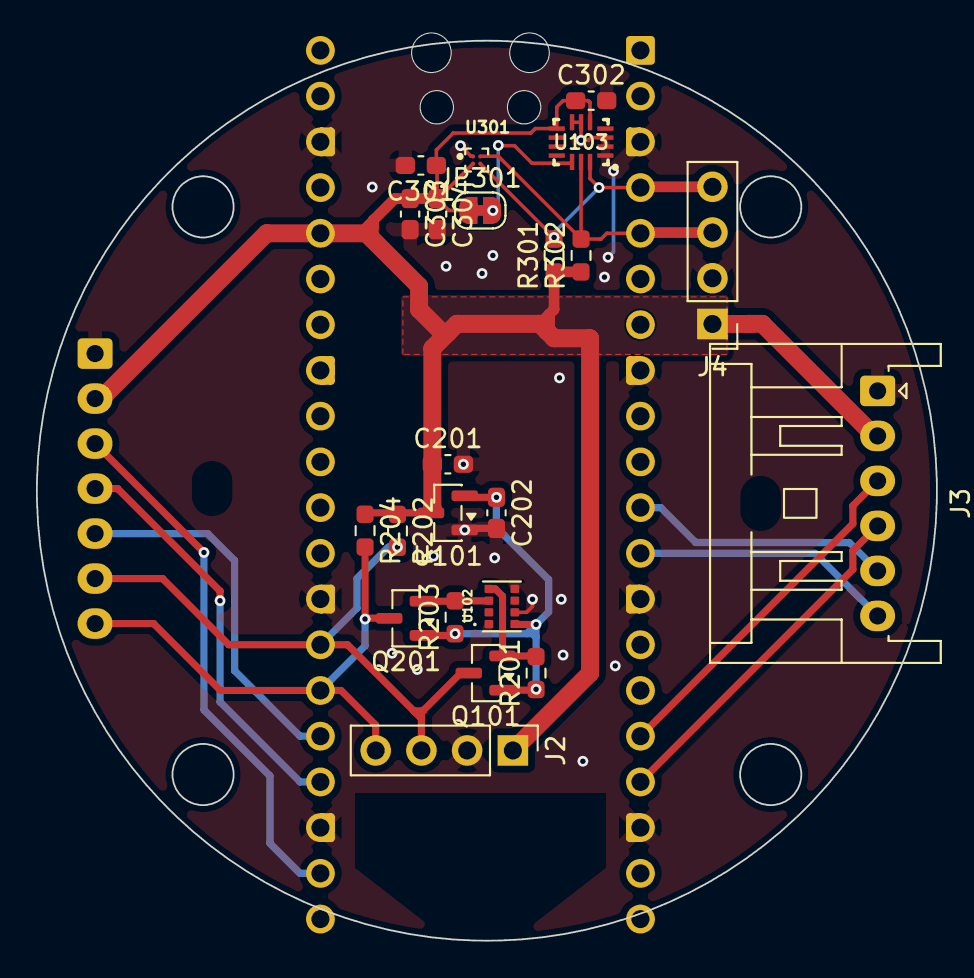
[picture p26: board avionics-core-noob.kicad_pcb from above]

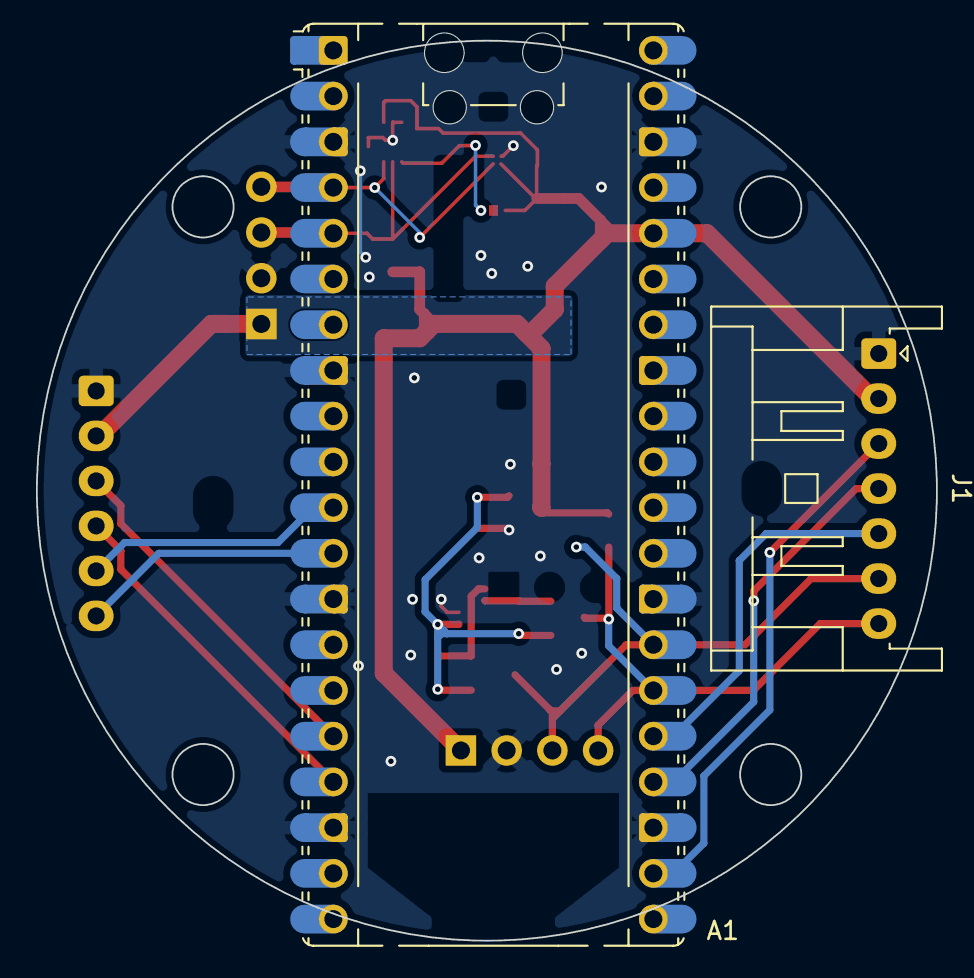
[picture p27: board avionics-core-noob.kicad_pcb from below]

Board: 2 copper layers, 50.0 x 50.0 mm, 24 parts (2 on the bottom side), 17 nets.
