Sles73/rocketa/pcb/avionics-com/avionics-com.kicad_pcb

## KiCad design pcb/avionics-com/avionics-com.kicad_pcb (2026-05-04)

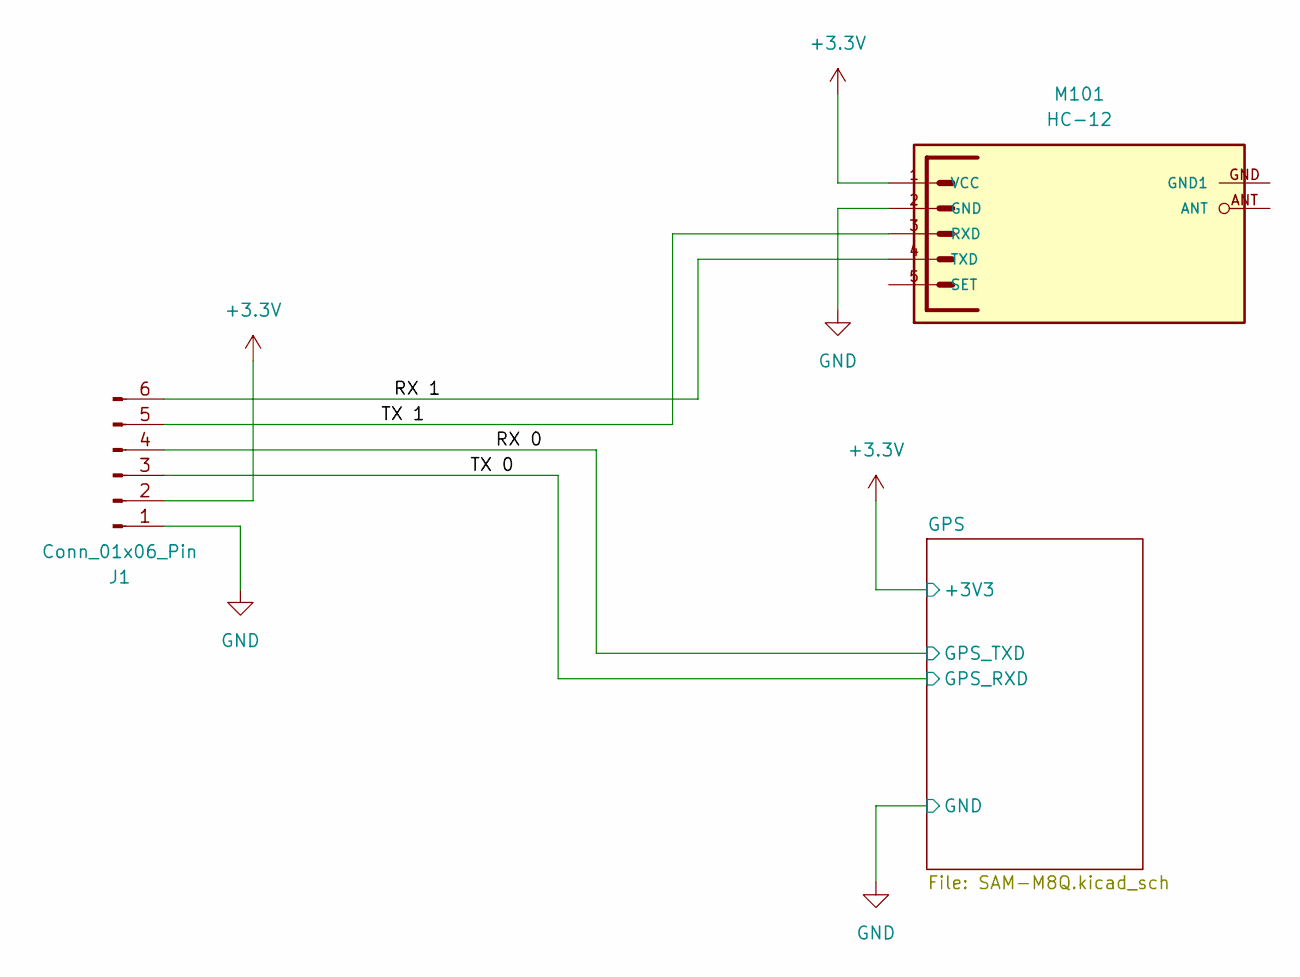
[picture p28: schematic avionics-com.kicad_sch]

Parts:
J1: Conn_01x06_Pin; JST_XA_S06B-XASK-1_1x06_P2.50mm_Horizontal
M101: HC-12; MA05-1

Connections:
+3.3V: J1.2, M101.1 (VCC); also elsewhere on the board
/RX 0: J1.4; also elsewhere on the board
/RX 1: J1.6, M101.4 (TXD)
/TX 0: J1.3; also elsewhere on the board
/TX 1: J1.5, M101.3 (RXD)
GND: J1.1, M101.2 (GND); also elsewhere on the board
unnamed: M101.GND (GND1), M101.GND1

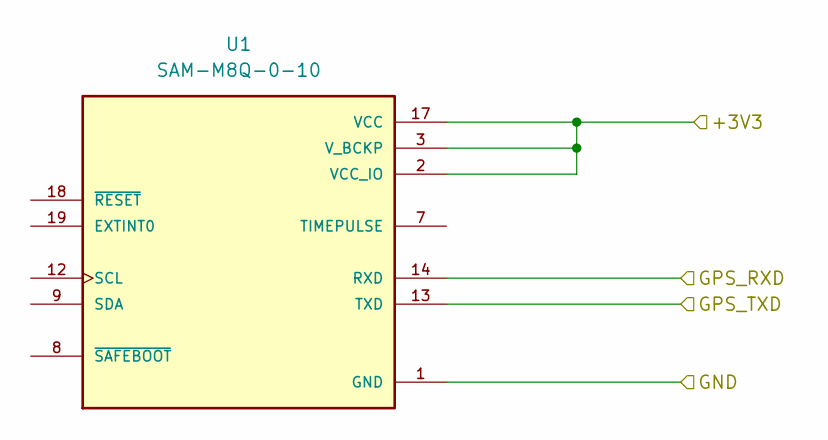
[picture p29: schematic SAM-M8Q.kicad_sch]

Parts:
U1: SAM-M8Q-0-10; MODULE_SAM-M8Q-0-10; PARTREV R07

Connections:
+3.3V: U1.2 (VCC_IO), U1.3 (V_BCKP), U1.17 (VCC); also elsewhere on the board
/RX 0: U1.13 (TXD); also elsewhere on the board
/TX 0: U1.14 (RXD); also elsewhere on the board
GND: U1.1 (GND), U1.4 (GND), U1.5 (GND), U1.6 (GND), U1.10 (GND), U1.11 (GND), U1.15 (GND), U1.16 (GND), U1.20 (GND); also elsewhere on the board

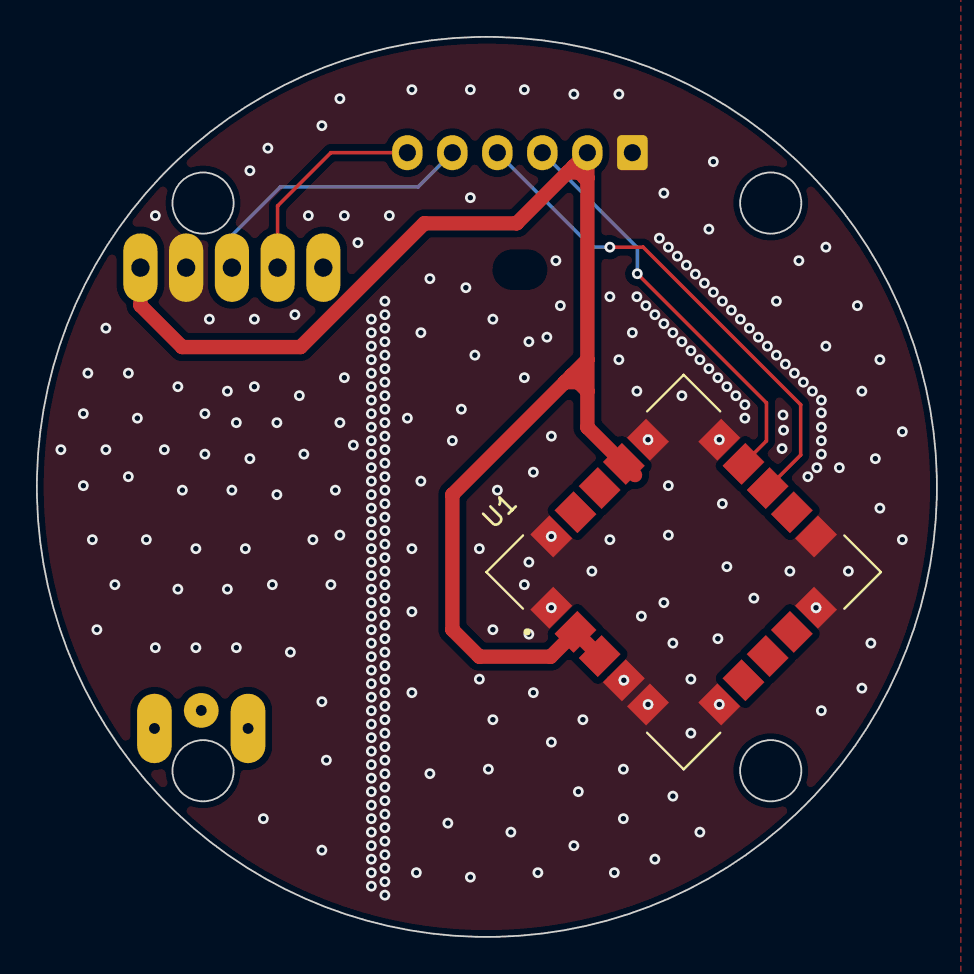
[picture p30: board avionics-com.kicad_pcb from above]

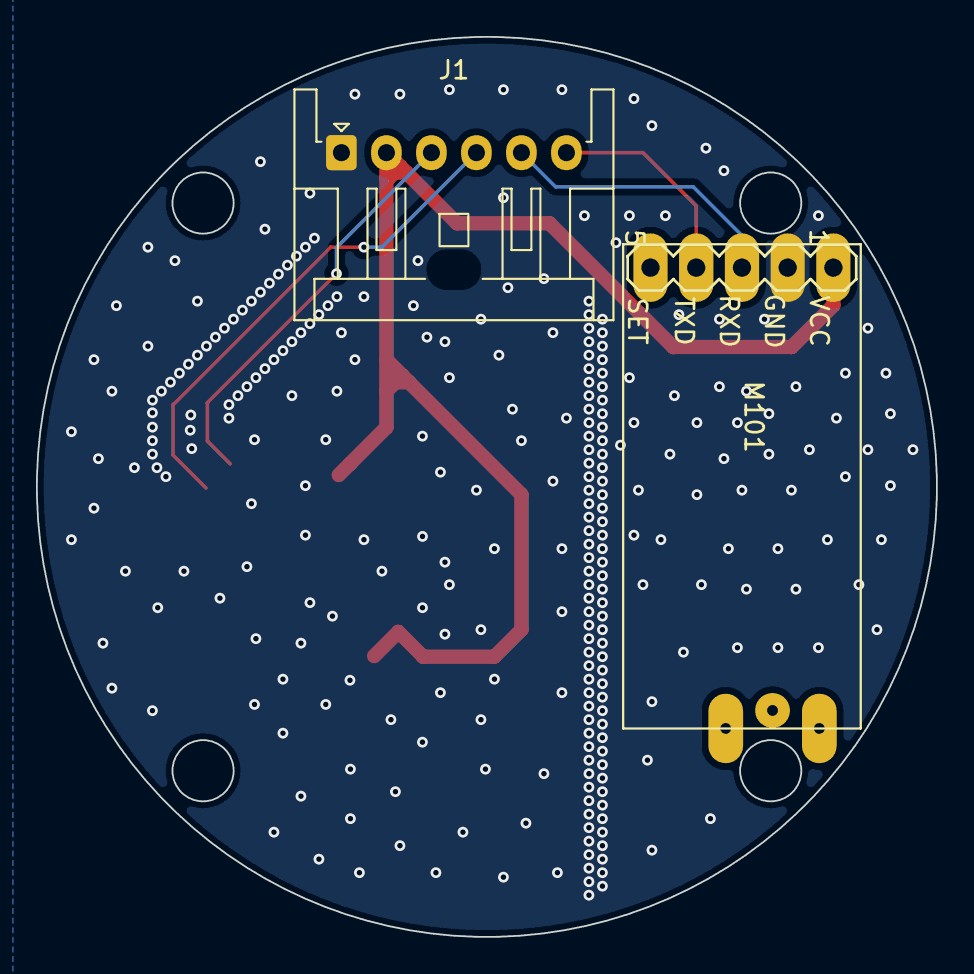
[picture p31: board avionics-com.kicad_pcb from below]

Board: 2 copper layers, 50.0 x 50.0 mm, 3 parts (2 on the bottom side), 7 nets.
